maxgrim/OOO2021Badge/appstore_apps/random/Niels/niels.bmp

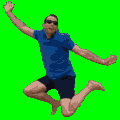
appstore_apps/random/Niels/niels.bmp
