maxgrim/OOO2021Badge/Hardware/Launchpad/artwork/stemma.png

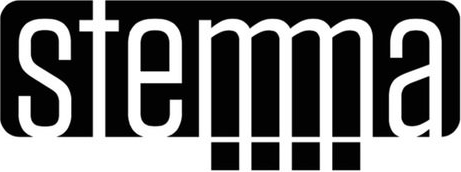
Hardware/Launchpad/artwork/stemma.png
