maxgrim/OOO2021Badge/Hardware/Launchpad/artwork/stemmaqt_qwiic.png

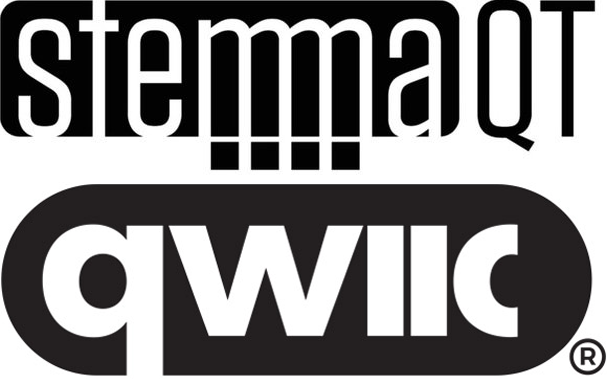
Hardware/Launchpad/artwork/stemmaqt_qwiic.png
