maxgrim/OOO2021Badge/Hardware/Moon/art/moon.png

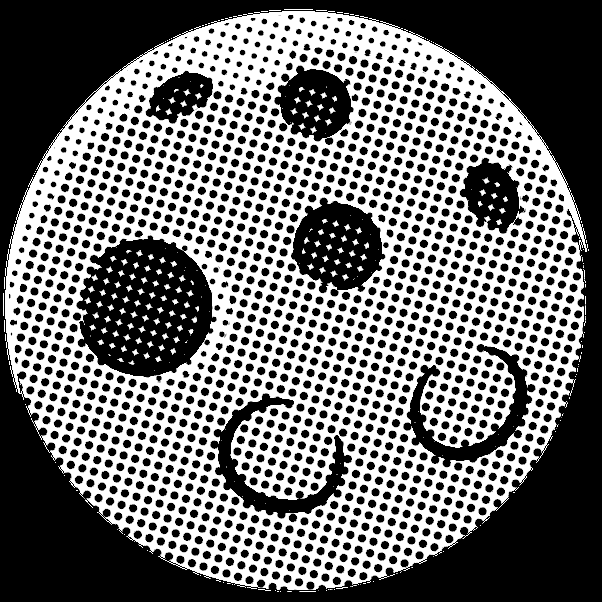
Hardware/Moon/art/moon.png
