maxgrim/OOO2021Badge/Hardware/Launchpad_Schematic.pdf

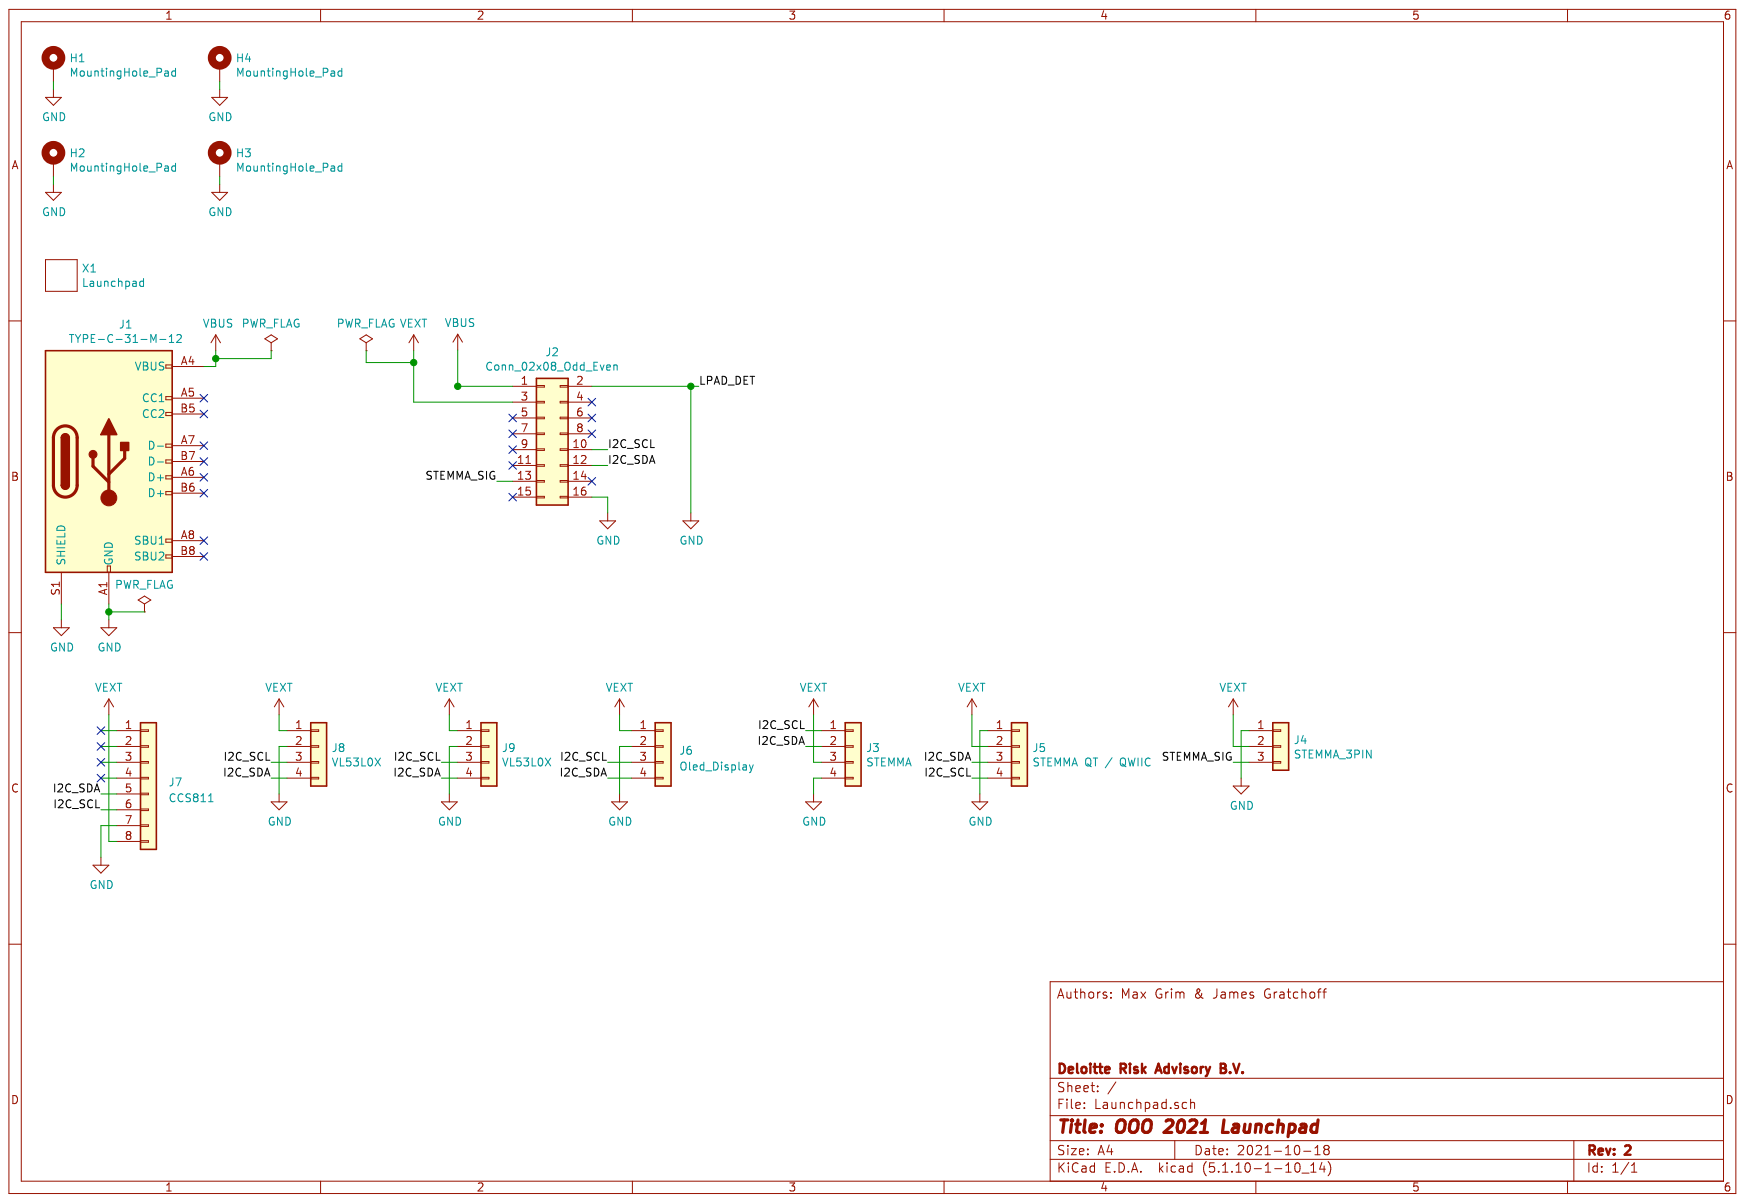
[picture p5: page 1]
