maxgrim/OOO2021Badge/Hardware/Moon_Schematic.pdf

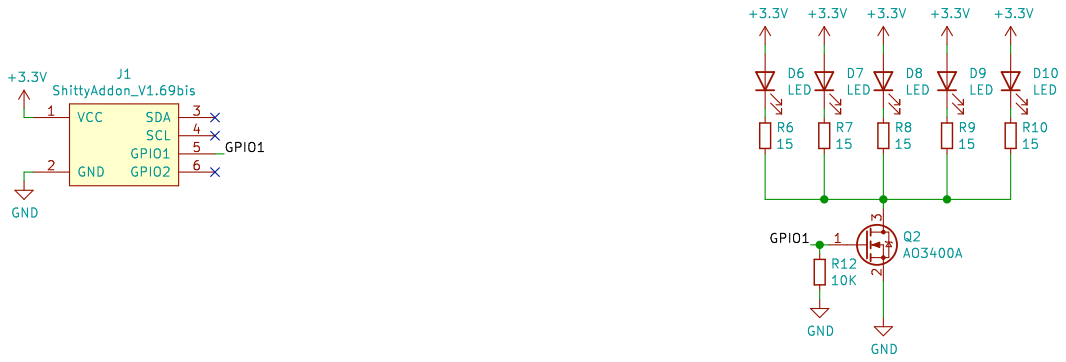
[picture p6: page 1]
