maxgrim/OOO2021Badge/Hardware/Moon/Moon_Addon.kicad_pcb

## KiCad design Hardware/Moon/Moon_Addon.kicad_pcb (2021-10-18)

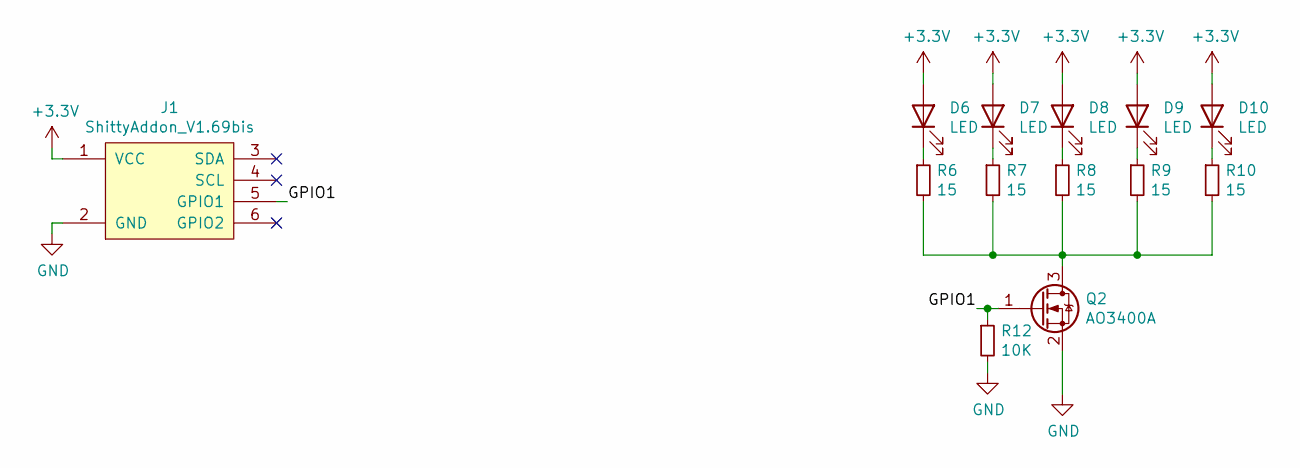
[picture p13: schematic Moon_Addon.sch, OOO 2021 Moon addon]

Parts:
D6, D7, D8, D9, D10: LED; LED_0805_2012Metric_Castellated; LCSC C34499
J1: ShittyAddon_V1.69bis; PinHeader_2x03_P2.54mm_Vertical
Q2: AO3400A; SOT-23; LCSC C20917
R6, R7, R8, R9, R10: 15; R_0805_2012Metric_Pad1.20x1.40mm_HandSolder; LCSC C17480
R12: 10K; R_0805_2012Metric_Pad1.20x1.40mm_HandSolder; LCSC C17414

Connections:
+3V3: D6.2 (A), D7.2 (A), D8.2 (A), D9.2 (A), D10.2 (A), J1.1 (VCC)
/GPIO1: J1.5 (GPIO1), Q2.1 (G), R12.1
GND: J1.2 (GND), Q2.2 (S), R12.2
unnamed: D6.1 (K), R6.1
unnamed: D7.1 (K), R7.1
unnamed: D8.1 (K), R8.1
unnamed: D9.1 (K), R9.1
unnamed: D10.1 (K), R10.1
unnamed: Q2.3 (D), R6.2, R7.2, R8.2, R9.2, R10.2

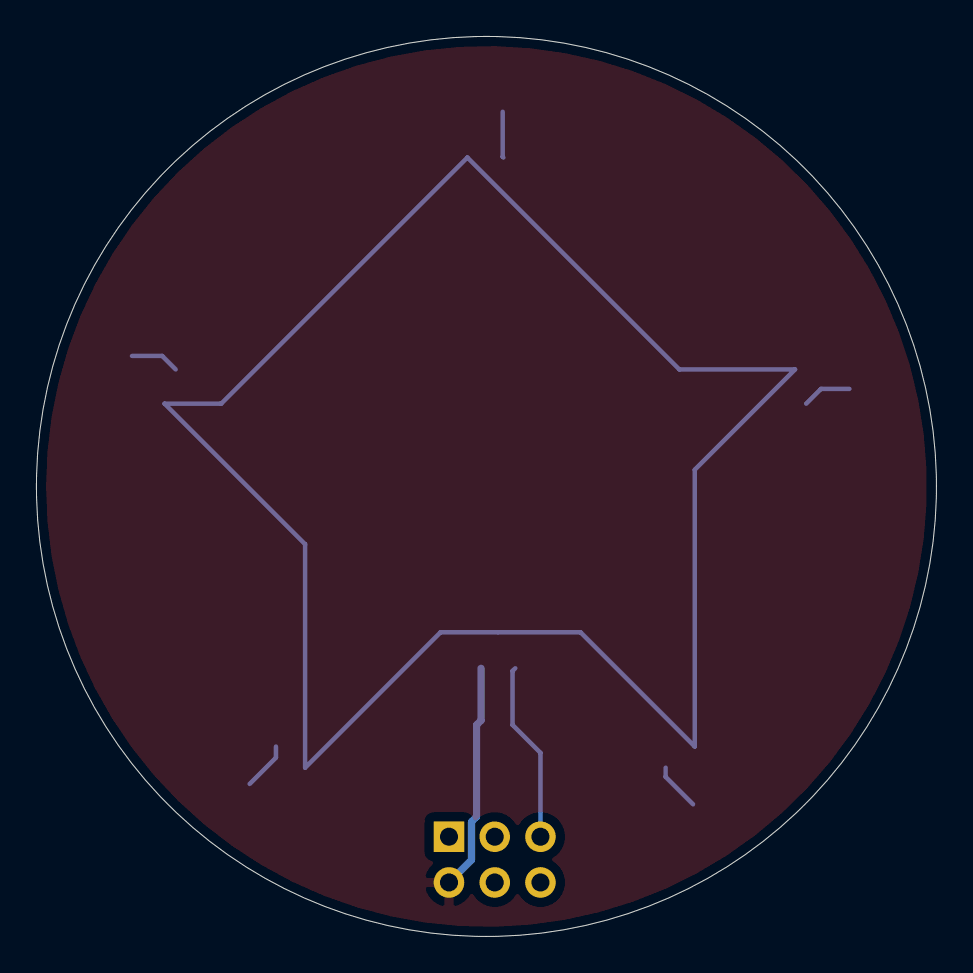
[picture p14: board Moon_Addon.kicad_pcb from above]

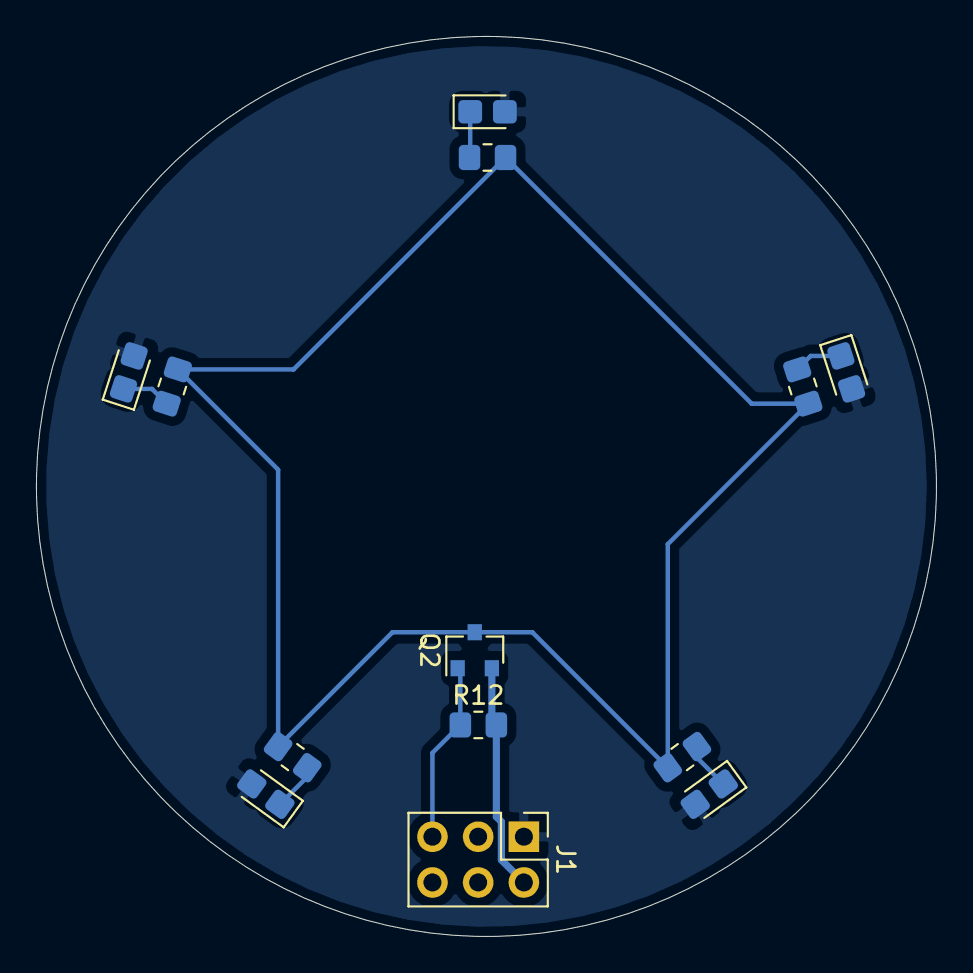
[picture p15: board Moon_Addon.kicad_pcb from below]

Board: 2 copper layers, 50.0 x 50.0 mm, 13 parts (13 on the bottom side), 9 nets.
