maxgrim/OOO2021Badge/Hardware/Launchpad/Launchpad.kicad_pcb

## KiCad design Hardware/Launchpad/Launchpad.kicad_pcb (2021-10-18)

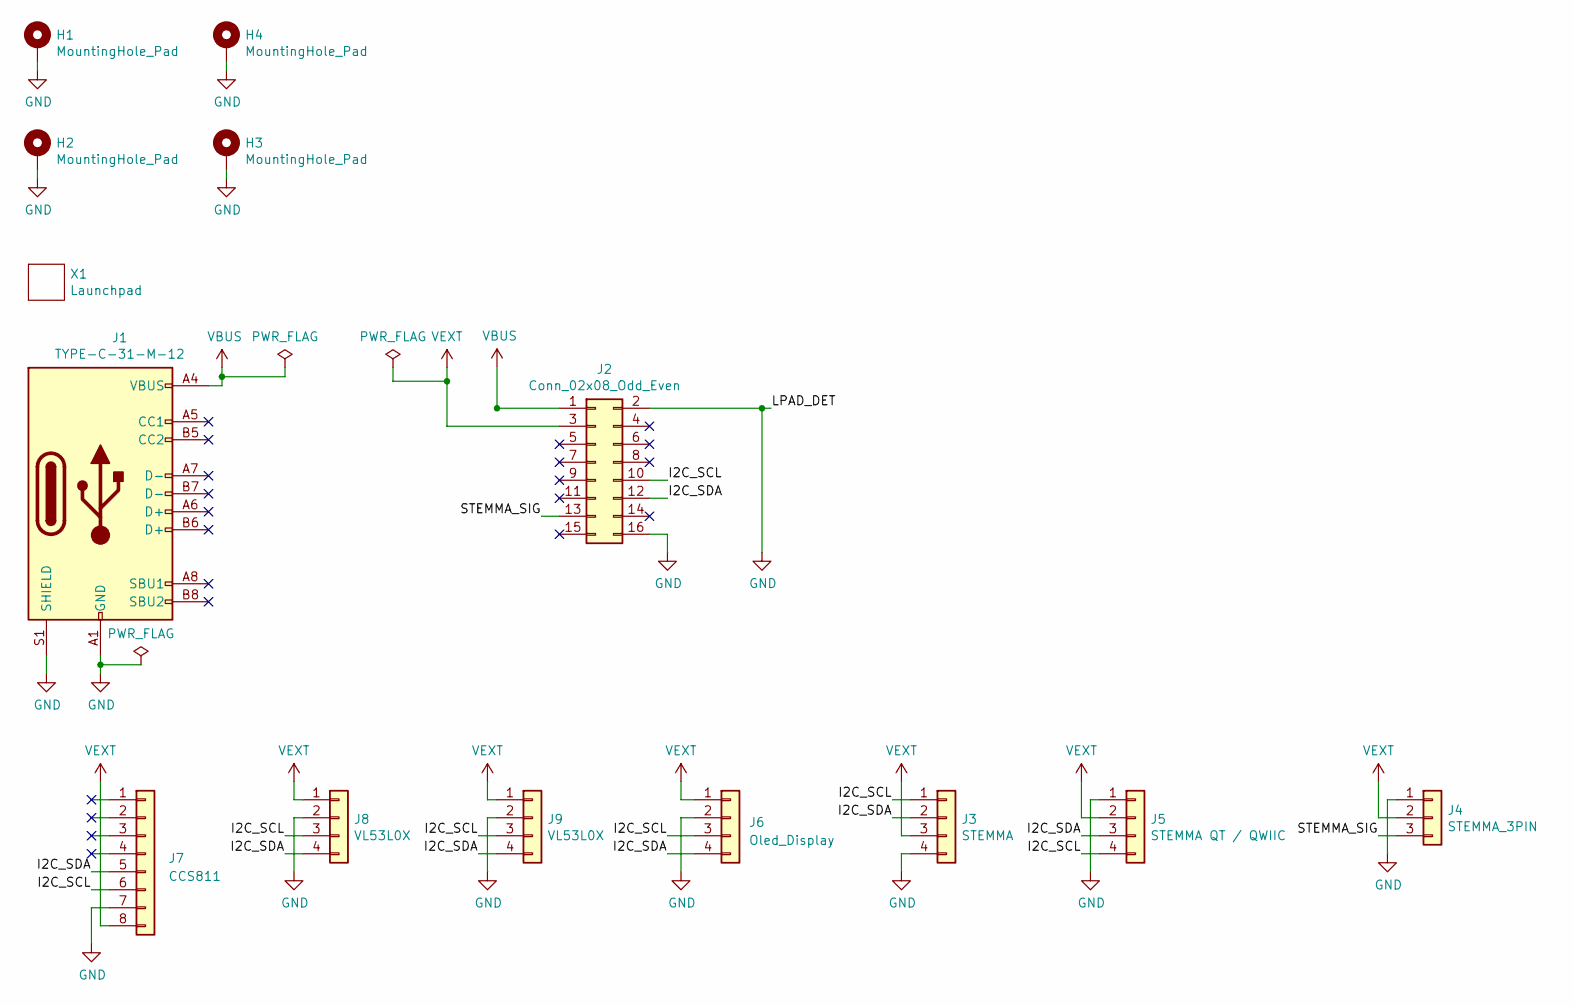
[picture p16: schematic Launchpad.sch, OOO 2021 Launchpad]

Parts:
H1, H2, H3, H4: MountingHole_Pad; MountingHole_4.3mm_M4_Pad_Via
J1: TYPE-C-31-M-12; LCSC C165948
J2: Conn_02x08_Odd_Even; PinHeader_2x08_P2.54mm_Horizontal; LCSC C492436
J3: STEMMA; CONN-SMD_2001SMT-4P-WT; LCSC C132498
J4: STEMMA_3PIN; CONN-SMD_3P-P2.00_2001SMT-3P_P; LCSC C155895
J5: STEMMA QT / QWIIC; CONN-SMD_1.0T-4P; LCSC C145956
J6: Oled_Display; PinSocket_1x04_P2.54mm_Horizontal; LCSC C225512
J7: CCS811; PinSocket_1x08_P2.54mm_Vertical; LCSC C350308
J8, J9: VL53L0X; PinSocket_1x04_P2.54mm_Vertical; LCSC C350310
X1: Launchpad

Connections:
/I2C_SCL: J2.10, J3.1, J5.4, J6.3, J7.6, J8.3, J9.3
/I2C_SDA: J2.12, J3.2, J5.3, J6.4, J7.5, J8.4, J9.4
/STEMMA_SIG: J2.13, J4.3
GND: H1.1, H2.1, H3.1, H4.1, J1.A1 (GND), J1.A12 (GND), J1.B1 (GND), J1.B12 (GND), J1.S1 (SHIELD), J2.2, J2.16, J3.4, J4.1, J5.1, J6.2, J7.7, J8.2, J9.2
VBUS: J1.A4 (VBUS), J1.A9 (VBUS), J1.B4 (VBUS), J1.B9 (VBUS), J2.1
VEXT: J2.3, J3.3, J4.2, J5.2, J6.1, J7.8, J8.1, J9.1

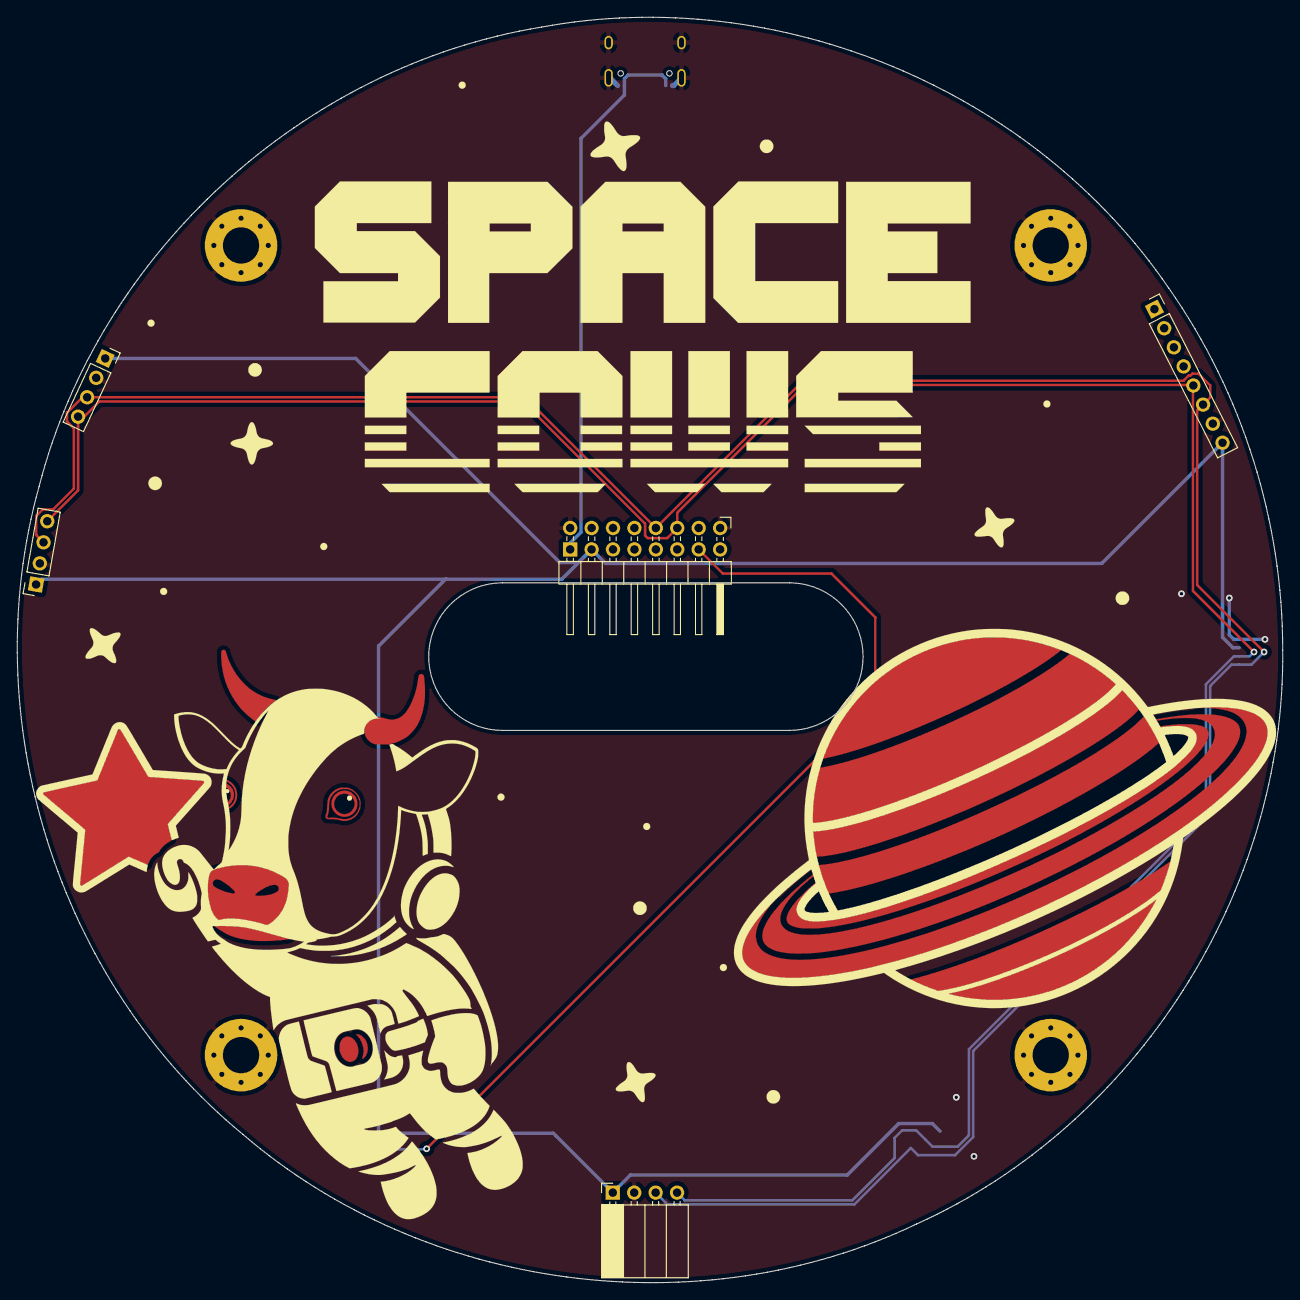
[picture p17: board Launchpad.kicad_pcb from above]

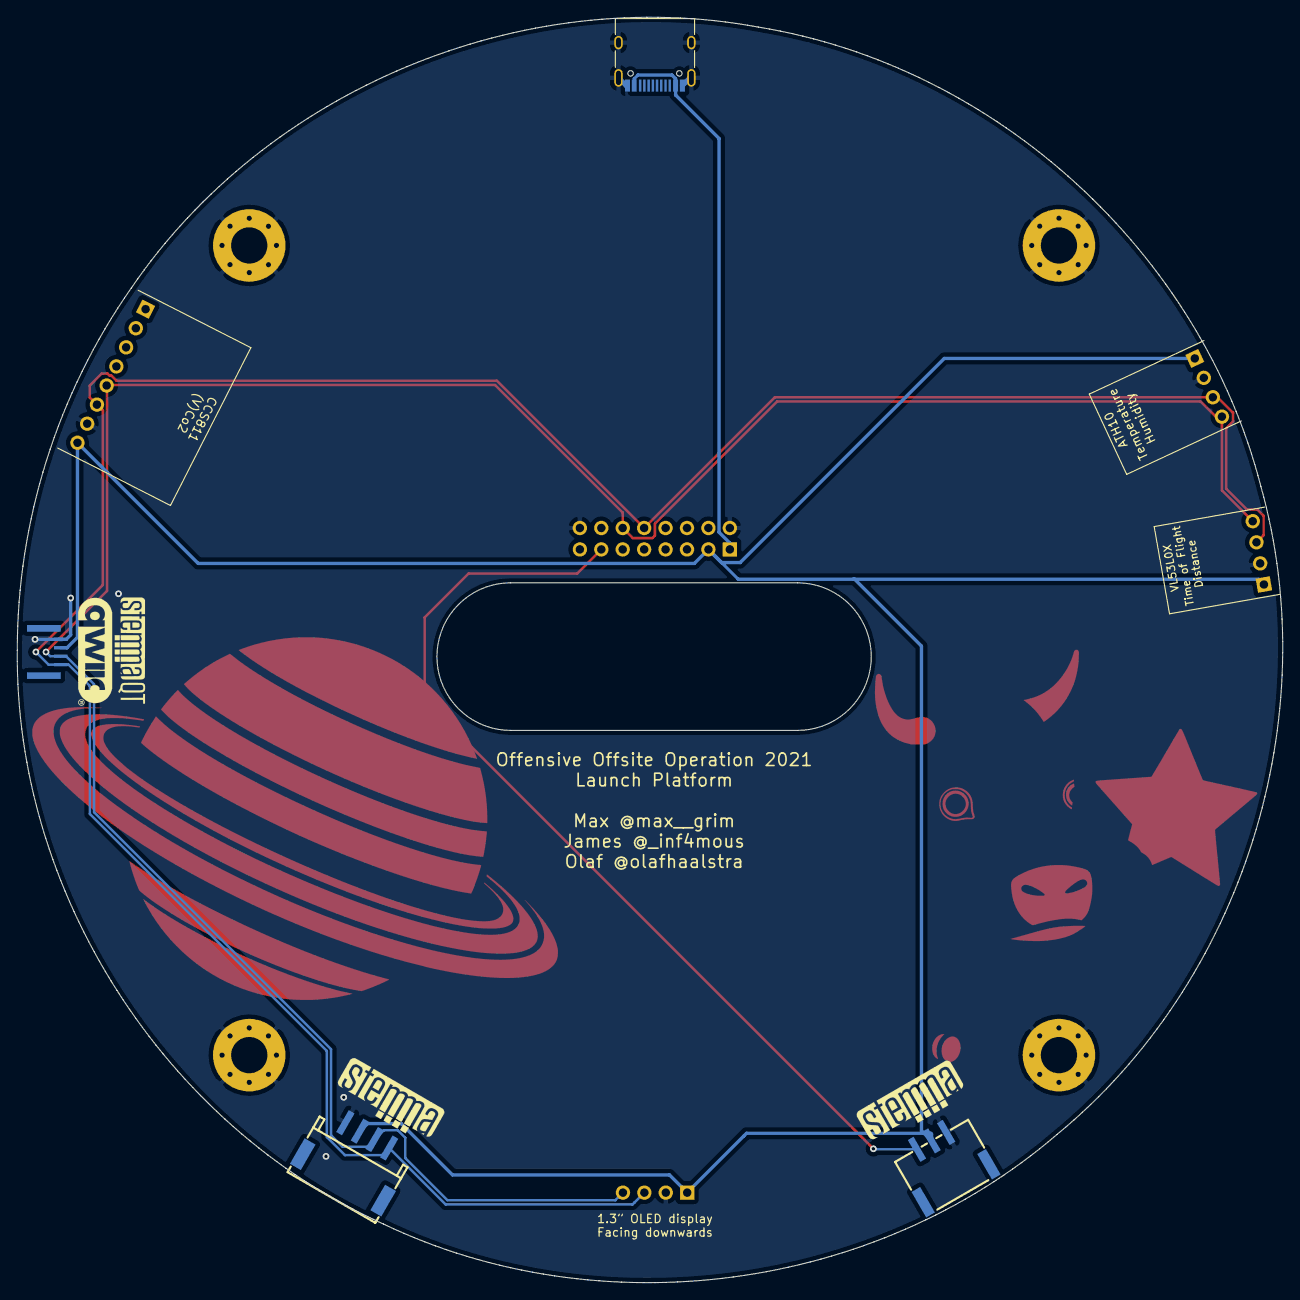
[picture p18: board Launchpad.kicad_pcb from below]

Board: 2 copper layers, 150.0 x 150.0 mm, 14 parts (4 on the bottom side), 6 nets.
