maxgrim/OOO2021Badge/Hardware/Rocket/OOO2021_Badge.kicad_pcb

## KiCad design Hardware/Rocket/OOO2021_Badge.kicad_pcb (2021-10-18)

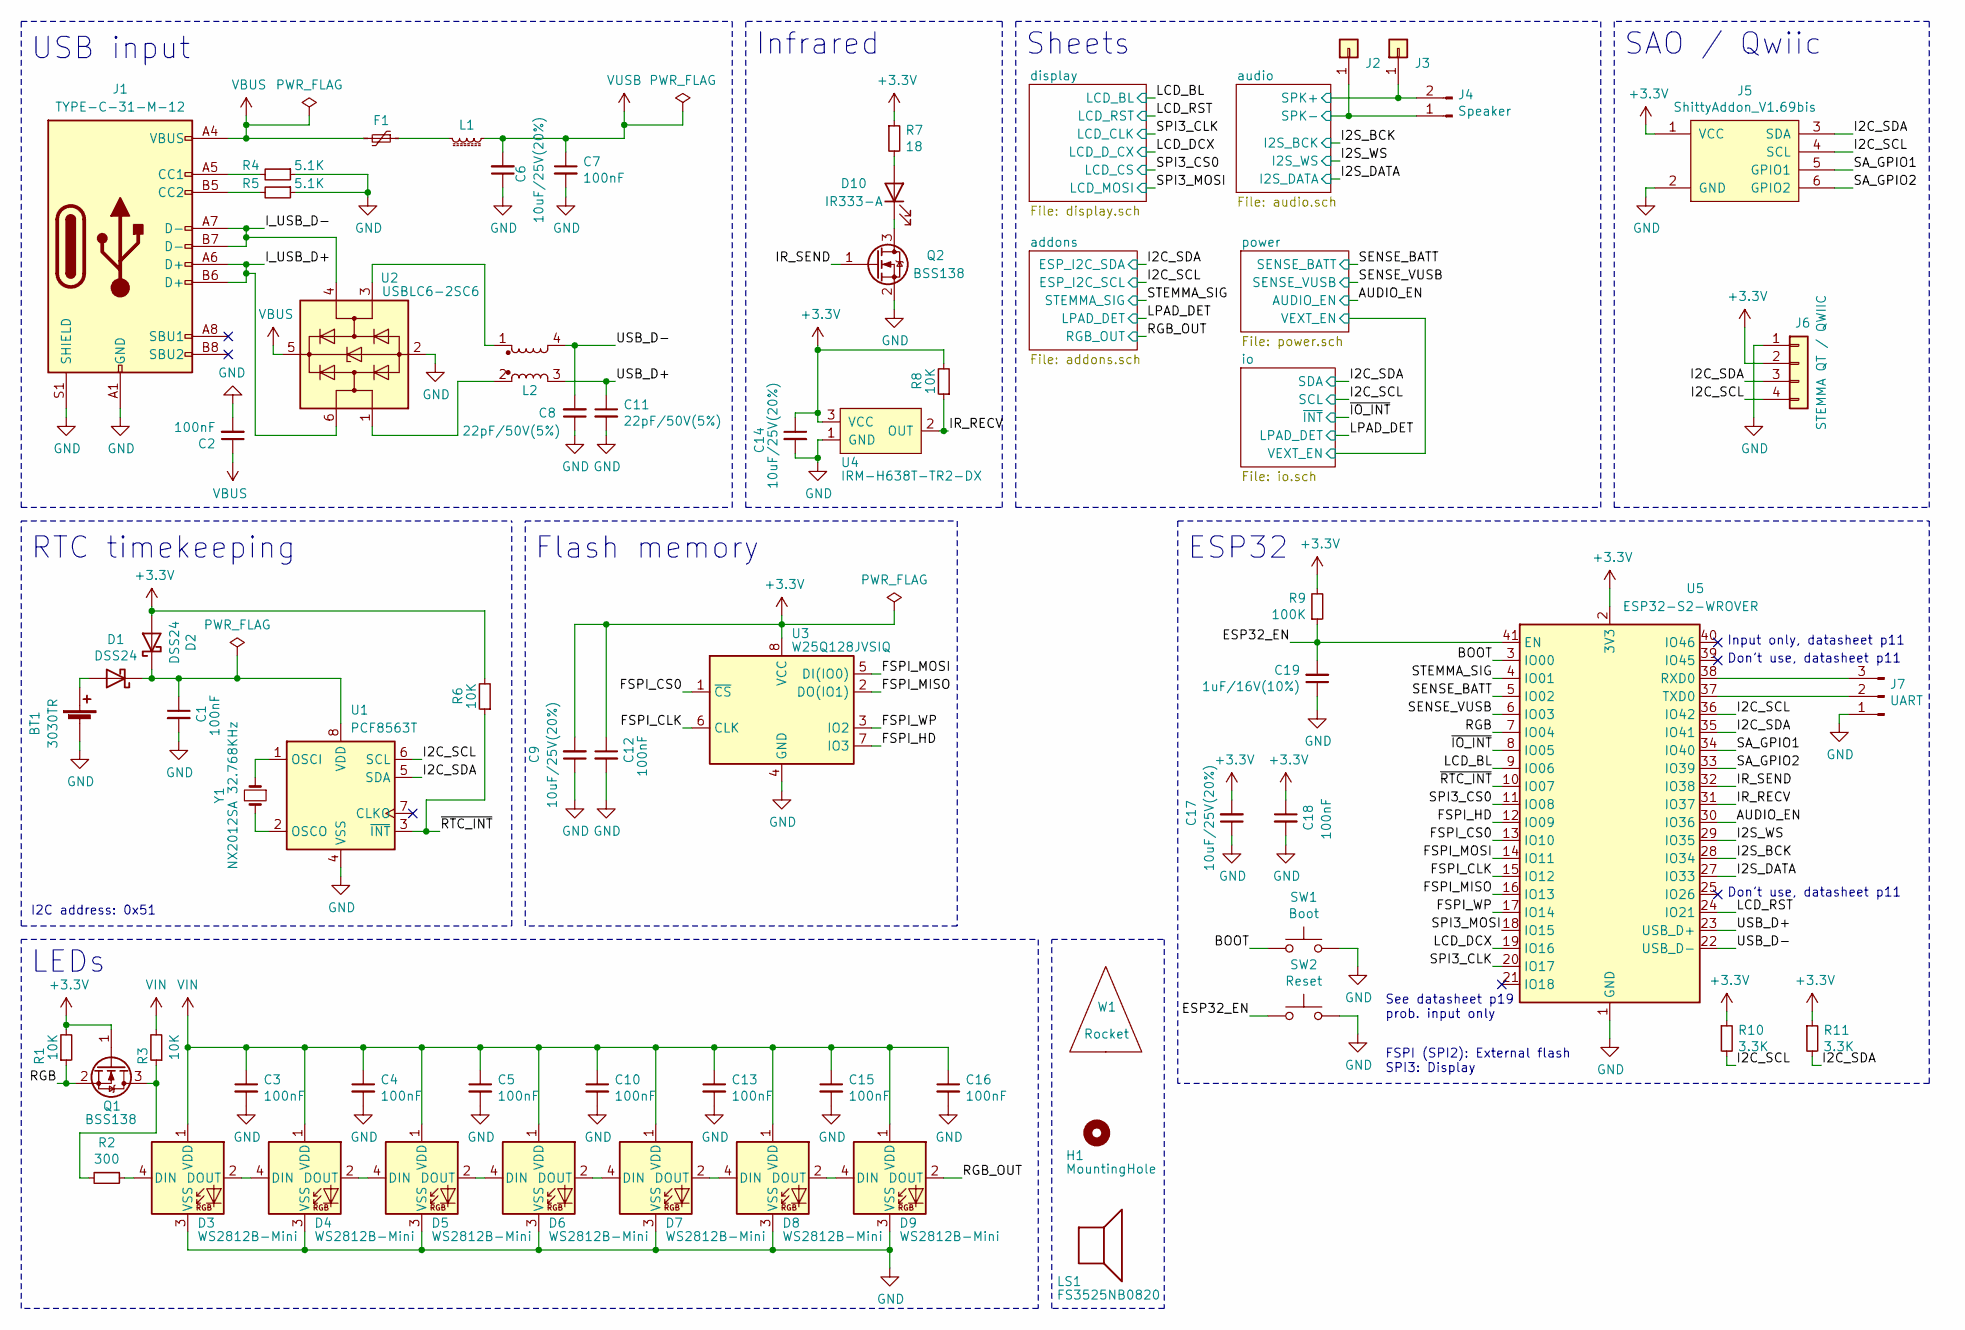
[picture p19: schematic OOO2021_Badge.sch, OOO 2021 Badge]

Parts:
BT1: 3030TR; 3030
C1, C2, C3, C4, C5, C7, C10, C12, C13, C15, C16, C18: 100nF; C_0402_1005Metric; LCSC C1581
C6, C9, C14, C17: 10uF/25V(20%); C_0603_1608Metric; LCSC C91606
C8, C11: 22pF/50V(5%); C_0402_1005Metric; LCSC C1555
C19: 1uF/16V(10%); C_0402_1005Metric; LCSC C29266
D1, D2: DSS24; D_SOD-123; LCSC C511865
D3, D4, D5, D6, D7, D8, D9: WS2812B-Mini; LED-SMD_4P-L3.5-W3.5-TL_WS2812B; LCSC C114583
D10: IR333-A; LED_D5.0mm; LCSC C264290
F1: JK-SMD0805-100; Fuse_0805_2012Metric_Castellated; LCSC C369152
H1: MountingHole; MountingHole_3mm
J1: TYPE-C-31-M-12; LCSC C165948
J2, J3: Conn_01x01; TestPoint_Pad_2.0x2.0mm
J4: Speaker; CONN-SMD_P1.25-H_1.25T-2PWT; LCSC C22074
J5: ShittyAddon_V1.69bis; PinSocket_2x03_P2.54mm_Vertical; LCSC C92272
J6: STEMMA QT / QWIIC; CONN-SMD_1.0T-4P; LCSC C145956
J7: UART; PinHeader_1x03_P2.54mm_Vertical_SMD_Pin1Left
L1: UPZ1608E221-2R2TF; L_0603_1608Metric; LCSC C96997
L2: ACM2012E-900-2P-T00; IND-SMD_4P-L2.0-W1.2-TL; LCSC C76573
LS1: FS3525NB0820; FS3525NB0820-H5.6; LCSC C782114
Q1, Q2: BSS138; SOT-23; LCSC C426569
R1, R3, R6, R8: 10K; R_0402_1005Metric; LCSC C25744
R2: 300; R_0402_1005Metric; LCSC C25102
R4, R5: 5.1K; R_0402_1005Metric; LCSC C25905
R7: 18; R_0603_1608Metric; LCSC C22830
R9: 100K; R_0402_1005Metric; LCSC C25530
R10, R11: 3.3K; R_0402_1005Metric; LCSC C25890
SW1: Boot; SW-SMD_4P-L5.1-W5.1-P3.70-LS6.5-TL-2; LCSC C318887
SW2: Reset; SW-SMD_4P-L5.1-W5.1-P3.70-LS6.5-TL-2; LCSC C318887
U1: PCF8563T; SOIC-8_3.9x4.9mm_P1.27mm; LCSC C7440
U2: USBLC6-2SC6; SOT-23-6; LCSC C558442
U3: W25Q128JVSIQ; SOIC-8_5.275x5.275mm_P1.27mm; LCSC C97521
U4: IRM-H638T-TR2-DX; LCSC C390031
U5: ESP32-S2-WROVER; LCSC C967027
W1: Rocket
Y1: NX2012SA 32.768KHz; Crystal_SMD_2012-2Pin_2.0x1.2mm; LCSC C528982

Connections:
+3V3: C9.2, C12.1, C14.1, C17.2, C18.1, D2.2 (A), J5.1 (VCC), J6.2, Q1.1 (G), R1.2, R6.2, R7.1, R8.2, R9.2, R10.1, R11.1, U3.8 (VCC), U4.3 (VCC), U5.2 (3V3); also elsewhere on the board
/AUDIO_EN: U5.30 (IO36); also elsewhere on the board
/BOOT: SW1.1, U5.3 (IO00)
/ESP32_EN: C19.2, R9.1, SW2.1, U5.41 (EN)
/FSPI_CLK: U3.6 (CLK), U5.15 (IO12)
/FSPI_CS0: U3.1 (~CS), U5.13 (IO10)
/FSPI_HD: U3.7 (IO3), U5.12 (IO09)
/FSPI_MISO: U3.2 (DO(IO1)), U5.16 (IO13)
/FSPI_MOSI: U3.5 (DI(IO0)), U5.14 (IO11)
/FSPI_WP: U3.3 (IO2), U5.17 (IO14)
/I2C_SCL: J5.4 (SCL), J6.4, R10.2, U1.6 (SCL), U5.36 (IO42); also elsewhere on the board
/I2C_SDA: J5.3 (SDA), J6.3, R11.2, U1.5 (SDA), U5.35 (IO41); also elsewhere on the board
/I2S_BCK: U5.28 (IO34); also elsewhere on the board
/I2S_DATA: U5.27 (IO33); also elsewhere on the board
/I2S_WS: U5.29 (IO35); also elsewhere on the board
/IR_RECV: R8.1, U4.2 (OUT), U5.31 (IO37)
/IR_SEND: Q2.1 (G), U5.32 (IO38)
/I_USB_D+: J1.A6 (D+), J1.B6 (D+), U2.6 (I/O1)
/I_USB_D-: J1.A7 (D-), J1.B7 (D-), U2.4 (I/O2)
/LCD_BL: U5.9 (IO06); also elsewhere on the board
/LCD_DCX: U5.19 (IO16); also elsewhere on the board
/LCD_RST: U5.24 (IO21); also elsewhere on the board
/RGB: Q1.2 (S), R1.1, U5.7 (IO04)
/RGB_OUT: D9.2 (DOUT); also elsewhere on the board
/SA_GPIO1: J5.5 (GPIO1), U5.34 (IO40)
/SA_GPIO2: J5.6 (GPIO2), U5.33 (IO39)
/SENSE_BATT: U5.5 (IO02); also elsewhere on the board
/SENSE_VUSB: U5.6 (IO03); also elsewhere on the board
/SPI3_CLK: U5.20 (IO17); also elsewhere on the board
/SPI3_CS0: U5.11 (IO08); also elsewhere on the board
/SPI3_MOSI: U5.18 (IO15); also elsewhere on the board
/STEMMA_SIG: U5.4 (IO01); also elsewhere on the board
/USB_D+: C11.1, L2.3, U5.23 (USB_D+)
/USB_D-: C8.2, L2.4, U5.22 (USB_D-)
/audio/SPK+: J3.1, J4.2; also elsewhere on the board
/audio/SPK-: J2.1, J4.1; also elsewhere on the board
/~IO_INT: U5.8 (IO05); also elsewhere on the board
/~RTC_INT: R6.1, U1.3 (~INT~), U5.10 (IO07)
GND: BT1.2 (-), C1.2, C2.2, C3.2, C4.2, C5.2, C6.1, C7.2, C8.1, C9.1, C10.2, C11.2, C12.2, C13.2, C14.2, C15.2, C16.2, C17.1, C18.2, C19.1, D3.3 (VSS), D4.3 (VSS), D5.3 (VSS), D6.3 (VSS), D7.3 (VSS), D8.3 (VSS), D9.3 (VSS), J1.A1 (GND), J1.A12 (GND), J1.B1 (GND), J1.B12 (GND), J1.S1 (SHIELD), J5.2 (GND), J6.1, J7.1, Q2.2 (S), R4.1, R5.1, SW1.2, SW2.2, U1.4 (VSS), U2.2 (GND), U3.4 (GND), U4.1 (GND), U5.1 (GND), U5.26 (GND), U5.42 (GND), U5.43 (GND); also elsewhere on the board
unnamed: BT1.1 (+), D1.2 (A)
unnamed: C1.1, D1.1 (K), D2.1 (K), U1.8 (VDD)
unnamed: D3.2 (DOUT), D4.4 (DIN)
unnamed: D3.4 (DIN), R2.1
unnamed: D4.2 (DOUT), D5.4 (DIN)
unnamed: D5.2 (DOUT), D6.4 (DIN)
unnamed: D6.2 (DOUT), D7.4 (DIN)
unnamed: D7.2 (DOUT), D8.4 (DIN)
unnamed: D8.2 (DOUT), D9.4 (DIN)
unnamed: D10.1 (K), Q2.3 (D)
unnamed: D10.2 (A), R7.2
unnamed: F1.1, L1.2
unnamed: J1.A5 (CC1), R4.2
unnamed: J1.B5 (CC2), R5.2
unnamed: J7.2, U5.37 (TXD0)
unnamed: J7.3, U5.38 (RXD0)
unnamed: L2.1, U2.3 (I/O2)
unnamed: L2.2, U2.1 (I/O1)
unnamed: Q1.3 (D), R2.2, R3.1
unnamed: U1.1 (OSCI), Y1.1
unnamed: U1.2 (OSCO), Y1.2
VBUS: C2.1, F1.2, J1.A4 (VBUS), J1.A9 (VBUS), J1.B4 (VBUS), J1.B9 (VBUS), U2.5 (VBUS); also elsewhere on the board
VIN: C3.1, C4.1, C5.1, C10.1, C13.1, C15.1, C16.1, D3.1 (VDD), D4.1 (VDD), D5.1 (VDD), D6.1 (VDD), D7.1 (VDD), D8.1 (VDD), D9.1 (VDD), R3.2; also elsewhere on the board
VUSB: C6.2, C7.1, L1.1; also elsewhere on the board

Notes on the sheet:
Don’t use, datasheet p11
See datasheet p19 prob. input only
Flash memory
USB input
ESP32
Sheets
LEDs
Infrared
Input only, datasheet p11
RTC timekeeping
FSPI (SPI2): External flash SPI3: Display
I2C address: 0x51
SAO / Qwiic

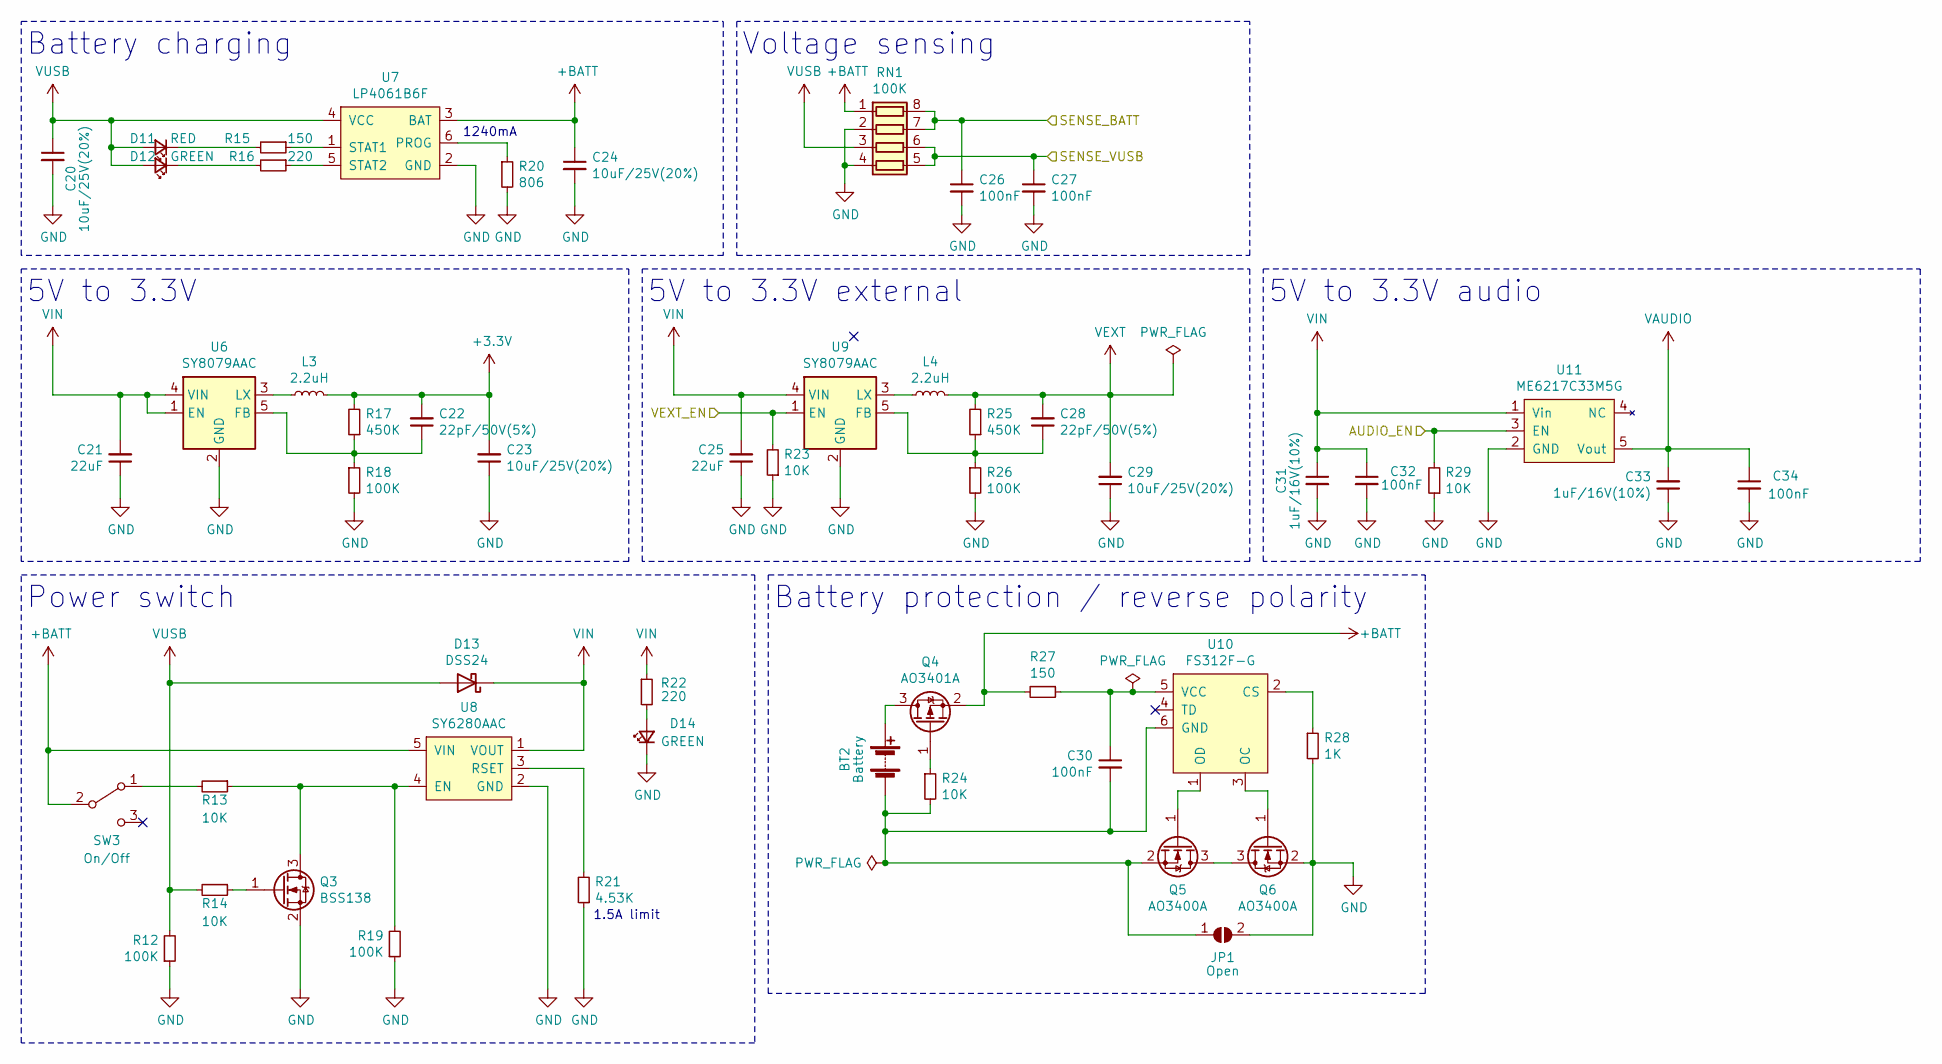
[picture p20: schematic power.sch, OOO 2021 Badge]

Parts:
BT2: Battery; BatteryHolder_Keystone_1042_1x18650
C20, C23, C24, C29: 10uF/25V(20%); C_0603_1608Metric; LCSC C91606
C21, C25: 22uF; C_0805_2012Metric; LCSC C45783
C22, C28: 22pF/50V(5%); C_0402_1005Metric; LCSC C1555
C26, C27, C30, C32, C34: 100nF; C_0402_1005Metric; LCSC C1581
C31, C33: 1uF/16V(10%); C_0402_1005Metric; LCSC C29266
D11: RED; LED_0603_1608Metric_Castellated; LCSC C84263
D12, D14: GREEN; LED_0603_1608Metric_Castellated; LCSC C205443
D13: DSS24; D_SOD-123; LCSC C511865
JP1: Open; SolderJumper-2_P1.3mm_Open_RoundedPad1.0x1.5mm
L3, L4: 2.2uH; L0806; LCSC C136243
Q3: BSS138; SOT-23; LCSC C426569
Q4: AO3401A; SOT-23; LCSC C15127
Q5, Q6: AO3400A; SOT-23; LCSC C344010
R12, R18, R19, R26: 100K; R_0402_1005Metric; LCSC C25530
R13, R14, R23, R24, R29: 10K; R_0402_1005Metric; LCSC C25744
R15, R27: 150; R_0402_1005Metric; LCSC C25082
R16, R22: 220; R_0402_1005Metric; LCSC C25091
R17, R25: 450K; R_0402_1005Metric; LCSC C407681
R20: 806; R_0402_1005Metric; LCSC C407662
R21: 4.53K; R_0402_1005Metric; LCSC C79537
R28: 1K; R_0402_1005Metric; LCSC C11702
RN1: 100K; R_Array_Convex_4x0603; LCSC C173315
SW3: On/Off; SW-TH_MSK12C02-HB; LCSC C431541
U6, U9: SY8079AAC; SOT-23-5; LCSC C133751
U7: LP4061B6F; SOT-23-6; LCSC C517027
U8: SY6280AAC; SOT-23-5; LCSC C55136
U10: FS312F-G; SOT-23-6; LCSC C82736
U11: ME6217C33M5G; SOT-23-5; LCSC C427602

Connections:
+3V3: C22.2, C23.2, L3.2, R17.2; also elsewhere on the board
+BATT: C24.1, Q4.2 (S), R27.2, RN1.1 (R1.1), SW3.2 (B), U7.3 (BAT), U8.5 (VIN)
/AUDIO_EN: R29.2, U11.3 (EN); also elsewhere on the board
/SENSE_BATT: C26.1, RN1.7 (R2.2), RN1.8 (R1.2); also elsewhere on the board
/SENSE_VUSB: C27.1, RN1.5 (R4.2), RN1.6 (R3.2); also elsewhere on the board
/io/VEXT_EN: R23.2, U9.1 (EN); also elsewhere on the board
GND: C20.2, C21.1, C23.1, C24.2, C25.1, C26.2, C27.2, C29.1, C31.2, C32.2, C33.1, C34.2, D14.1 (K), JP1.2 (B), Q3.2 (S), Q6.2 (S), R12.1, R18.2, R19.1, R20.2, R21.1, R23.1, R26.2, R28.2, R29.1, RN1.2 (R2.1), RN1.4 (R4.1), U6.2 (GND), U7.2 (GND), U8.2 (GND), U9.2 (GND), U11.2 (GND); also elsewhere on the board
unnamed: BT2.1 (+), Q4.3 (D)
unnamed: BT2.2 (-), C30.2, JP1.1 (A), Q5.2 (S), R24.2, U10.6 (GND)
unnamed: C22.1, R17.1, R18.1, U6.5 (FB)
unnamed: C28.1, R25.1, R26.1, U9.5 (FB)
unnamed: C30.1, R27.1, U10.5 (VCC)
unnamed: D11.1 (K), R15.2
unnamed: D12.1 (K), R16.2
unnamed: D14.2 (A), R22.2
unnamed: L3.1, U6.3 (LX)
unnamed: L4.1, U9.3 (LX)
unnamed: Q3.1 (G), R14.1
unnamed: Q3.3 (D), R13.1, R19.2, U8.4 (EN)
unnamed: Q4.1 (G), R24.1
unnamed: Q5.1 (G), U10.1 (OD)
unnamed: Q5.3 (D), Q6.3 (D)
unnamed: Q6.1 (G), U10.3 (OC)
unnamed: R13.2, SW3.1 (A)
unnamed: R15.1, U7.1 (STAT1)
unnamed: R16.1, U7.5 (STAT2)
unnamed: R20.1, U7.6 (PROG)
unnamed: R21.2, U8.3 (RSET)
unnamed: R28.1, U10.2 (CS)
VAUDIO: C33.2, C34.1, U11.5 (Vout); also elsewhere on the board
VEXT: C28.2, C29.2, L4.2, R25.2; also elsewhere on the board
VIN: C21.2, C25.2, C31.1, C32.1, D13.1 (K), R22.1, U6.1 (EN), U6.4 (VIN), U8.1 (VOUT), U9.4 (VIN), U11.1 (Vin); also elsewhere on the board
VUSB: C20.1, D11.2 (A), D12.2 (A), D13.2 (A), R12.2, R14.2, RN1.3 (R3.1), U7.4 (VCC); also elsewhere on the board

Notes on the sheet:
Battery charging
Power switch
5V to 3.3V
Battery protection / reverse polarity
Voltage sensing
5V to 3.3V external
5V to 3.3V audio
1.5A limit
1240mA

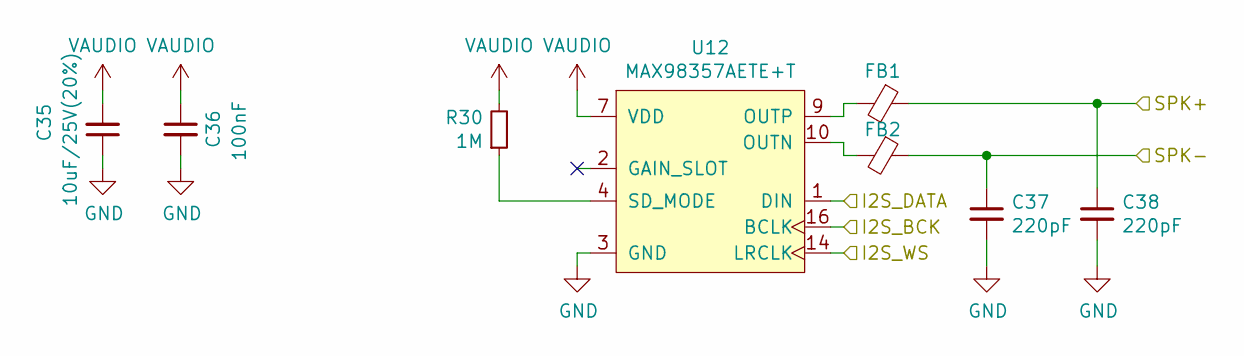
[picture p21: schematic audio.sch]

Parts:
C35: 10uF/25V(20%); C_0603_1608Metric; LCSC C91606
C36: 100nF; C_0402_1005Metric; LCSC C1581
C37, C38: 220pF; C_0402_1005Metric; LCSC C466236
FB1, FB2: PBY160808T-102Y-N; L_0603_1608Metric; LCSC C142079
R30: 1M; R_0402_1005Metric; LCSC C26083
U12: MAX98357AETE+T; QFN50P300X300X80-17N; LCSC C910544

Connections:
/I2S_BCK: U12.16 (BCLK); also elsewhere on the board
/I2S_DATA: U12.1 (DIN); also elsewhere on the board
/I2S_WS: U12.14 (LRCLK); also elsewhere on the board
/audio/SPK+: C38.1, FB1.1; also elsewhere on the board
/audio/SPK-: C37.1, FB2.1; also elsewhere on the board
GND: C35.1, C36.2, C37.2, C38.2, U12.3 (GND); also elsewhere on the board
unnamed: FB1.2, U12.9 (OUTP)
unnamed: FB2.2, U12.10 (OUTN)
unnamed: R30.1, U12.4 (SD_MODE)
VAUDIO: C35.2, C36.1, R30.2, U12.7 (VDD); also elsewhere on the board

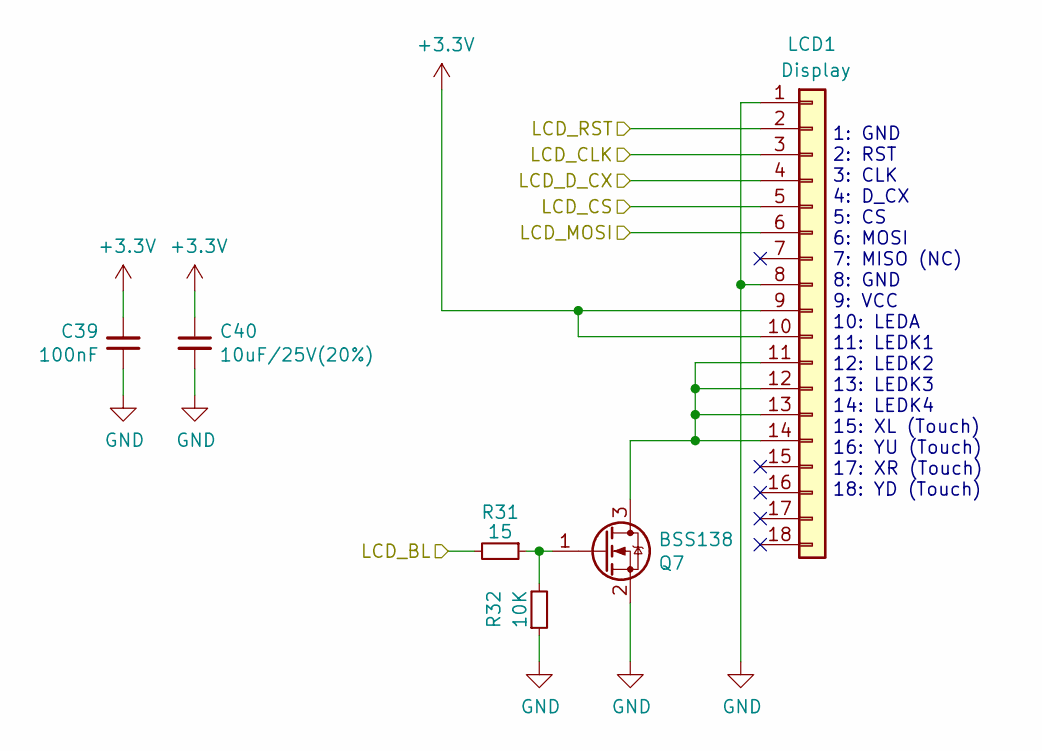
[picture p22: schematic display.sch]

Parts:
C39: 100nF; C_0402_1005Metric; LCSC C1581
C40: 10uF/25V(20%); C_0603_1608Metric; LCSC C91606
LCD1: Display; ILI9341_2.4
Q7: BSS138; SOT-23; LCSC C426569
R31: 15; R_0402_1005Metric; LCSC C208806
R32: 10K; R_0402_1005Metric; LCSC C25744

Connections:
+3V3: C39.2, C40.1, LCD1.9, LCD1.10; also elsewhere on the board
/LCD_BL: R31.2; also elsewhere on the board
/LCD_DCX: LCD1.4; also elsewhere on the board
/LCD_RST: LCD1.2; also elsewhere on the board
/SPI3_CLK: LCD1.3; also elsewhere on the board
/SPI3_CS0: LCD1.5; also elsewhere on the board
/SPI3_MOSI: LCD1.6; also elsewhere on the board
GND: C39.1, C40.2, LCD1.1, LCD1.8, Q7.2 (S), R32.1; also elsewhere on the board
unnamed: LCD1.11, LCD1.12, LCD1.13, LCD1.14, Q7.3 (D)
unnamed: Q7.1 (G), R31.1, R32.2

Notes on the sheet:
1: GND 2: RST 3: CLK 4: D_CX 5: CS 6: MOSI 7: MISO (NC) 8: GND 9: VCC 10: LEDA 11: LEDK1 12: LEDK2 13: LEDK3 14: LEDK4 15: XL (Touch) 16: YU (Touch) 17: XR (Touch) 18: YD (Touch)
