maxgrim/OOO2021Badge/Hardware/Rocket/OOO2021_Badge.kicad_pcb

## KiCad design Hardware/Rocket/OOO2021_Badge.kicad_pcb (continued)

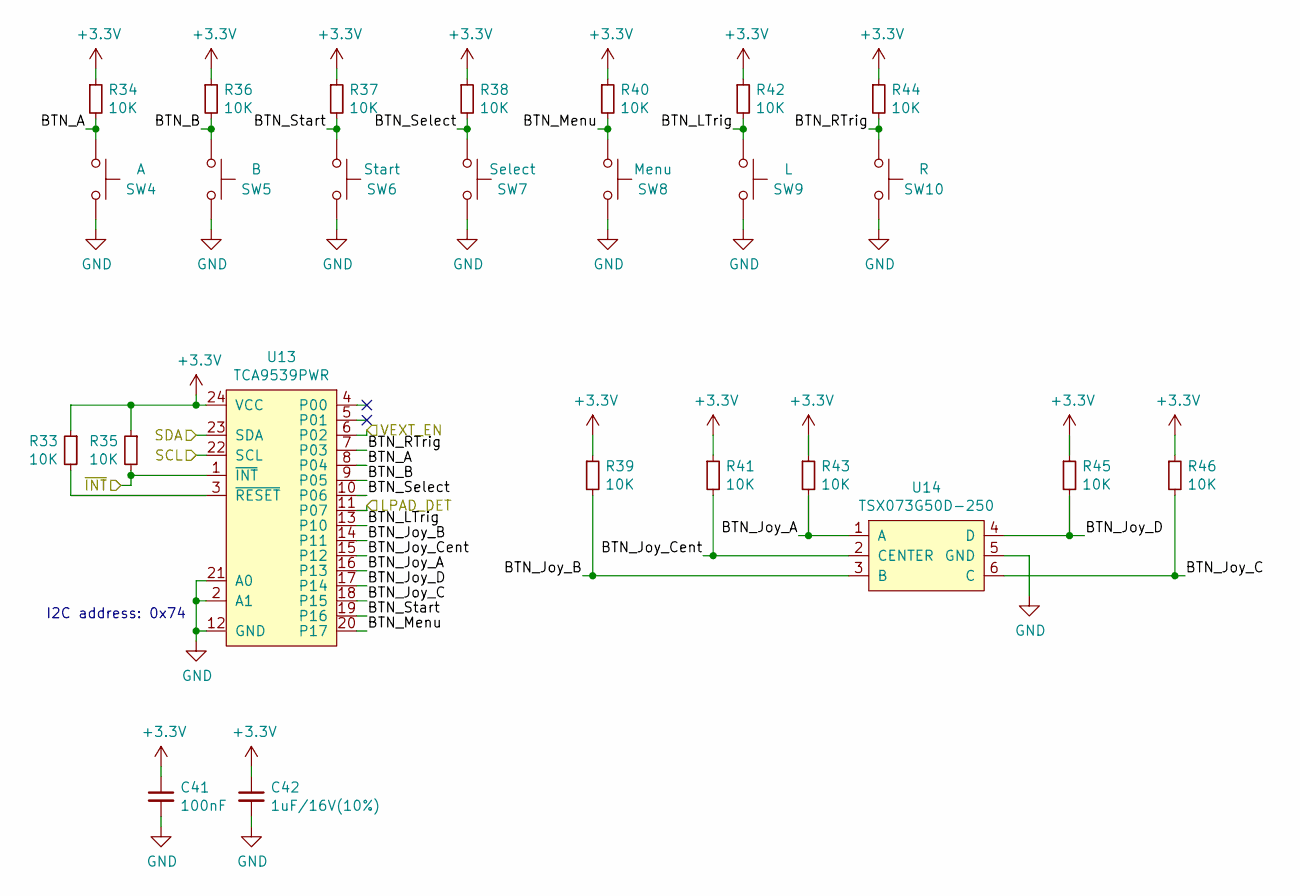
[picture p23: schematic io.sch]

Parts:
C41: 100nF; C_0402_1005Metric; LCSC C1581
C42: 1uF/16V(10%); C_0402_1005Metric; LCSC C29266
R33, R34, R35, R36, R37, R38, R39, R40, R41, R42, R43, R44, R45, R46: 10K; R_0402_1005Metric; LCSC C25744
SW4: A; SW-SMD_4P-L5.1-W5.1-P3.70-LS6.5-TL-2; LCSC C318887
SW5: B; SW-SMD_4P-L5.1-W5.1-P3.70-LS6.5-TL-2; LCSC C318887
SW6: Start; SW-SMD_4P-L5.1-W5.1-P3.70-LS6.5-TL-2; LCSC C318887
SW7: Select; SW-SMD_4P-L5.1-W5.1-P3.70-LS6.5-TL-2; LCSC C318887
SW8: Menu; SW-SMD_4P-L5.1-W5.1-P3.70-LS6.5-TL-2; LCSC C318887
SW9: L; KEY-TH_4P-L7.5-W6.8-P4.50-LS7.2; LCSC C455134
SW10: R; KEY-TH_4P-L7.5-W6.8-P4.50-LS7.2; LCSC C455134
U13: TCA9539PWR; TSSOP-24_4.4x7.8mm_P0.65mm; LCSC C131972
U14: TSX073G50D-250; SW-SMD_TSX073G50D1-250; LCSC C722953

Connections:
+3V3: C41.1, C42.1, R33.1, R34.1, R35.1, R36.1, R37.1, R38.1, R39.1, R40.1, R41.1, R42.1, R43.1, R44.1, R45.1, R46.1, U13.24 (VCC); also elsewhere on the board
/I2C_SCL: U13.22 (SCL); also elsewhere on the board
/I2C_SDA: U13.23 (SDA); also elsewhere on the board
/LPAD_DET: U13.11 (P07); also elsewhere on the board
/io/BTN_A: R34.2, SW4.1, U13.8 (P04)
/io/BTN_B: R36.2, SW5.1, U13.9 (P05)
/io/BTN_Joy_A: R43.2, U13.16 (P13), U14.1 (A)
/io/BTN_Joy_B: R39.2, U13.14 (P11), U14.3 (B)
/io/BTN_Joy_C: R46.2, U13.18 (P15), U14.6 (C)
/io/BTN_Joy_Cent: R41.2, U13.15 (P12), U14.2 (CENTER)
/io/BTN_Joy_D: R45.2, U13.17 (P14), U14.4 (D)
/io/BTN_LTrig: R42.2, SW9.1, U13.13 (P10)
/io/BTN_Menu: R40.2, SW8.1, U13.20 (P17)
/io/BTN_RTrig: R44.2, SW10.1, U13.7 (P03)
/io/BTN_Select: R38.2, SW7.1, U13.10 (P06)
/io/BTN_Start: R37.2, SW6.1, U13.19 (P16)
/io/VEXT_EN: U13.6 (P02); also elsewhere on the board
/~IO_INT: R35.2, U13.1 (~INT); also elsewhere on the board
GND: C41.2, C42.2, SW4.2, SW5.2, SW6.2, SW7.2, SW8.2, SW9.2, SW10.2, U13.2 (A1), U13.12 (GND), U13.21 (A0), U14.5 (GND); also elsewhere on the board
unnamed: R33.2, U13.3 (~RESET)

Notes on the sheet:
I2C address: 0x74

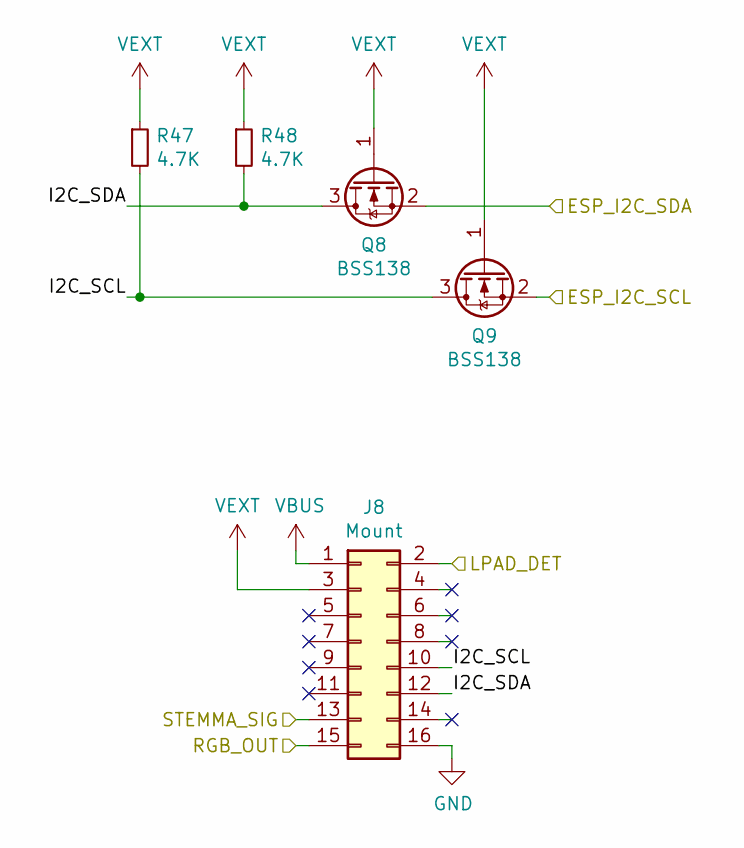
[picture p24: schematic addons.sch]

Parts:
J8: Mount; PinSocket_2x08_P2.54mm_Vertical; LCSC C30734
Q8, Q9: BSS138; SOT-23; LCSC C426569
R47, R48: 4.7K; R_0402_1005Metric; LCSC C25900

Connections:
/I2C_SCL: Q9.2 (S); also elsewhere on the board
/I2C_SDA: Q8.2 (S); also elsewhere on the board
/LPAD_DET: J8.2; also elsewhere on the board
/RGB_OUT: J8.15; also elsewhere on the board
/STEMMA_SIG: J8.13; also elsewhere on the board
/addons/I2C_SCL: J8.10, Q9.3 (D), R47.2
/addons/I2C_SDA: J8.12, Q8.3 (D), R48.2
GND: J8.16; also elsewhere on the board
VBUS: J8.1; also elsewhere on the board
VEXT: J8.3, Q8.1 (G), Q9.1 (G), R47.1, R48.1; also elsewhere on the board

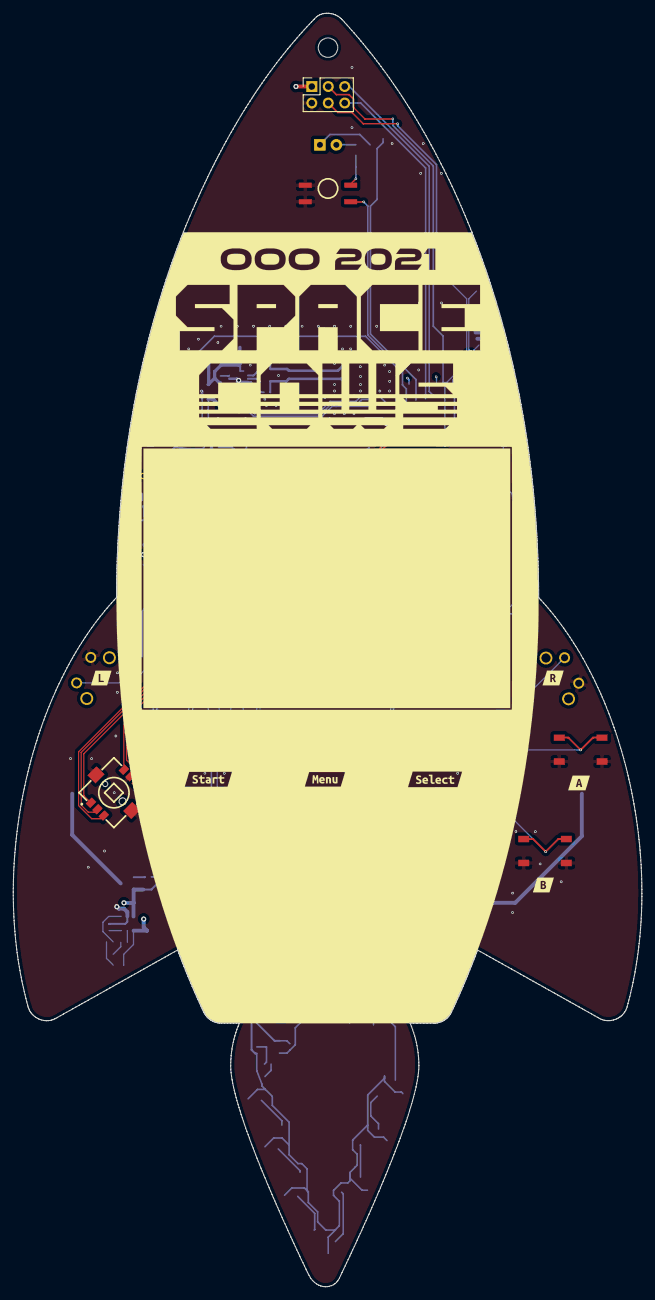
[picture p25: board OOO2021_Badge.kicad_pcb from above]

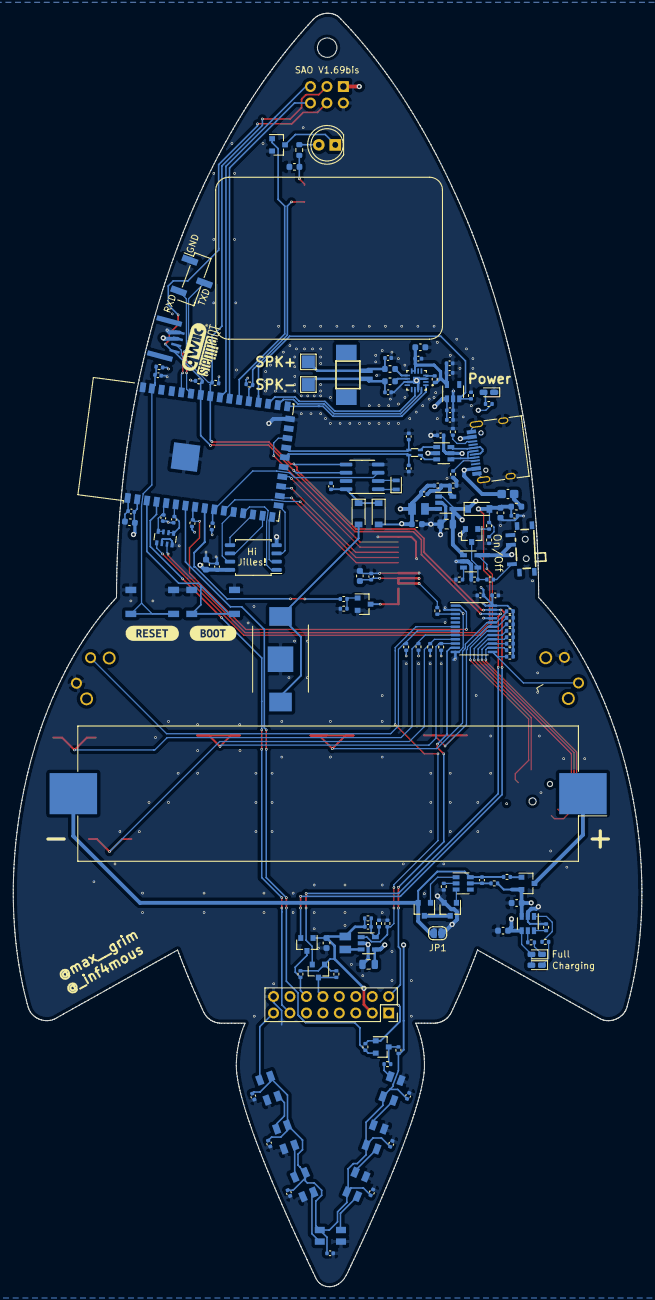
[picture p26: board OOO2021_Badge.kicad_pcb from below]

Board: 4 copper layers, 97.0 x 196.6 mm, 167 parts (152 on the bottom side), 110 nets.

Other parts of the board:
kibuzzard-612644FA, kibuzzard-612645F1, kibuzzard-6126412F, kibuzzard-6126450F, kibuzzard-6126461B, kibuzzard-61264142: G***; label
