maxgrim/OOO2021Badge/(commit log)

2021-10-18 Added .gitignore for KiCad projects
2021-10-18 Added hardware KiCad files
    Hardware files for Launchpad, Rocket (badge), and Moon addon
    [Launchpad-B_Cu.gbr, Launchpad-B_Mask.gbr, Launchpad-B_Paste.gbr, Launchpad-B_SilkS.gbr, Launchpad-Edge_Cuts.gbr, Launchpad-F_Cu.gbr, Launchpad-F_Mask.gbr, Launchpad-F_Paste.gbr]
2021-10-18 Added circuitpython submodule
2021-10-18 Attempt to re-add circuitpython
2021-10-18 Added circuitpython as submodule
2021-10-23 Moved circuitpython to ooo_2021 branch
2021-10-23 Battery Level App
2021-10-25 Laser tag modifications
2021-10-26 Removed circuitpython
2021-10-26 Remove circuitpython
2021-10-26 Added circuitpython ooo2021_6
2021-10-26 Updated circuitpython
2021-10-26 Point circuitpython to ooo2021_7
2021-10-27 Added battery simbol for charging
2021-10-27 Added battery indicator
2021-11-02 Fix menu back bug, added metadata.json reading
    [appstore.py, code.py, utils.py]
